uhi22/accucheck2/(commit log)

2026-06-24 implementated resistance measurement. python tool for visualization of dynamics during resistance measurement
2026-06-24 refined ground concept for clean measurement
2026-06-24 added status LED and watchdog+retry behavior
2026-06-24 disable wifi modem sleep to get a smooth current consumption
2026-06-27 fix: avoid reset due to network connection loss. Add network diagnostics incl visualization
    [accucheck2.ino, dcir.cpp, dcir.h, logger.cpp, logger.h]
